Gernreich/four-hole-ocarinas/step/four-hole-ocarinas-rhombic-dodecahedron.step

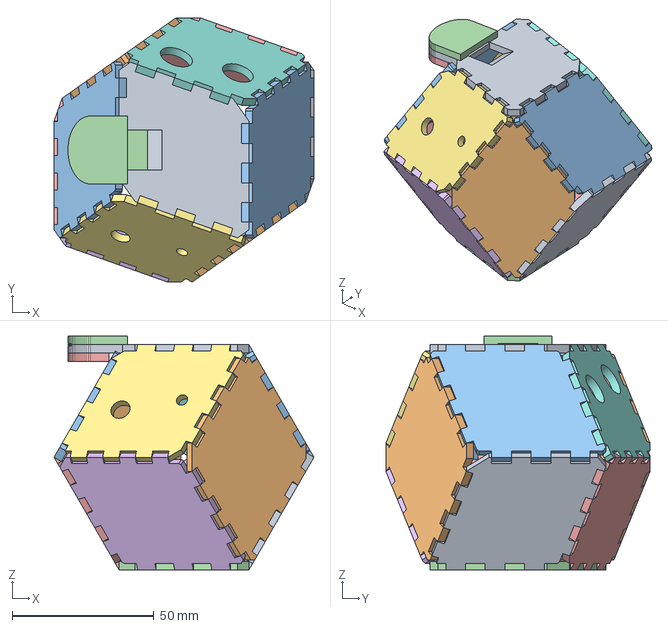
[picture p1: CAD file, 2026-11-12]
step/four-hole-ocarinas-rhombic-dodecahedron.step
91.6 x 93.2 x 82.4 mm
