Gernreich/four-hole-ocarinas/step/four-hole-ocarinas-square-antiprism.step

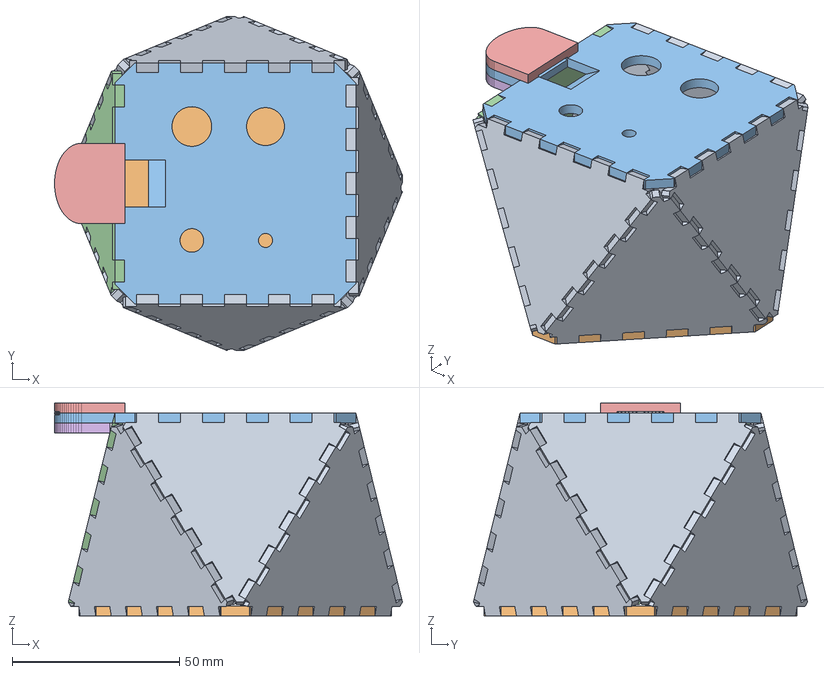
[picture p2: CAD file, 2026-11-08]
step/four-hole-ocarinas-square-antiprism.step
103.9 x 99.8 x 63.5 mm
