Gernreich/four-hole-ocarinas/step/four-hole-ocarinas-icosahedron.step

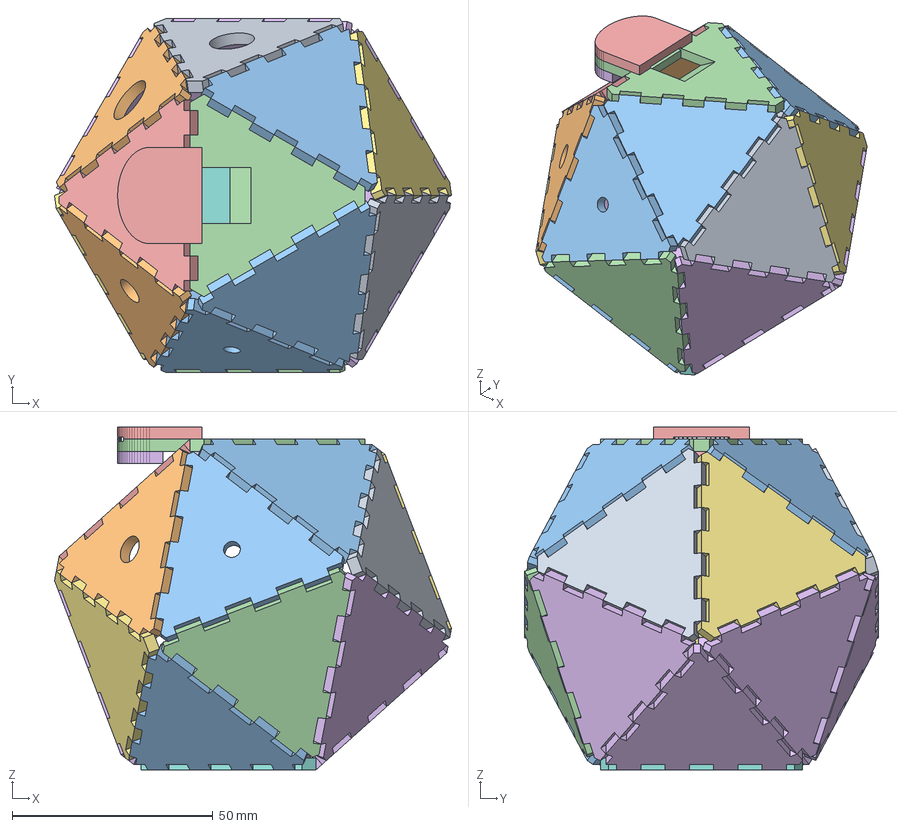
[picture p3: CAD file, 2026-11-08]
step/four-hole-ocarinas-icosahedron.step
98.9 x 88.2 x 85.4 mm
