Gernreich/four-hole-ocarinas/step/four-hole-ocarinas-octahedron.step

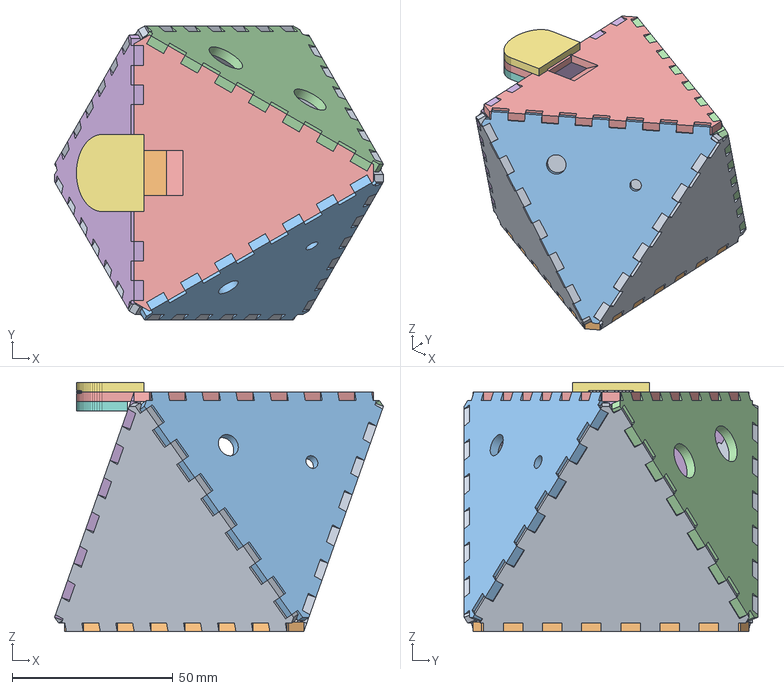
[picture p4: CAD file, 2026-11-08]
step/four-hole-ocarinas-octahedron.step
102.5 x 91.5 x 77.7 mm
