Gernreich/four-hole-ocarinas/step/four-hole-ocarinas-octagon.step

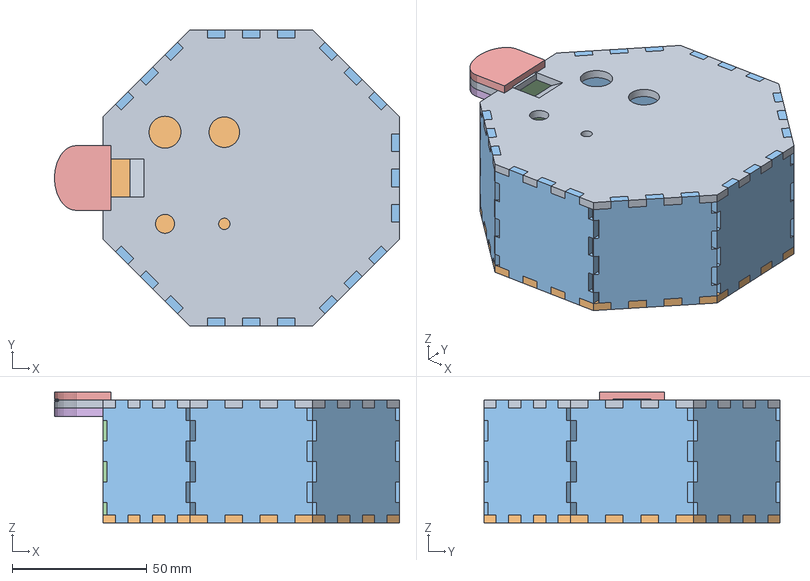
[picture p5: CAD file, 2026-11-08]
step/four-hole-ocarinas-octagon.step
128.0 x 110.0 x 48.6 mm
