Gernreich/four-hole-ocarinas/step/four-hole-ocarinas-cuboctahedron.step

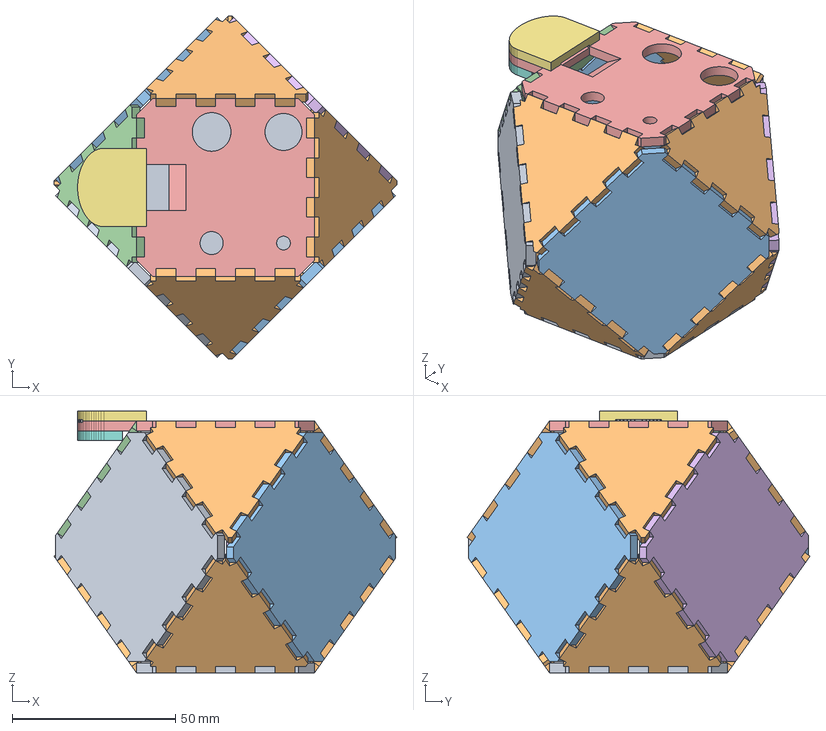
[picture p6: CAD file, 2026-11-08]
step/four-hole-ocarinas-cuboctahedron.step
105.0 x 105.0 x 80.1 mm
