Gernreich/four-hole-ocarinas/step/four-hole-ocarinas-hexagonal-prism.step

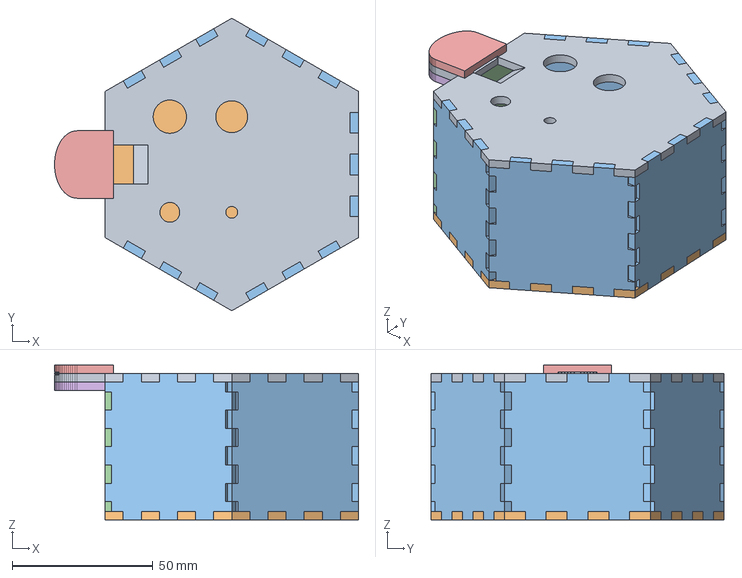
[picture p7: CAD file, 2026-11-08]
step/four-hole-ocarinas-hexagonal-prism.step
108.1 x 104.0 x 55.0 mm
