Gernreich/four-hole-ocarinas/step/four-hole-ocarinas-elongated-square-pyramid.step

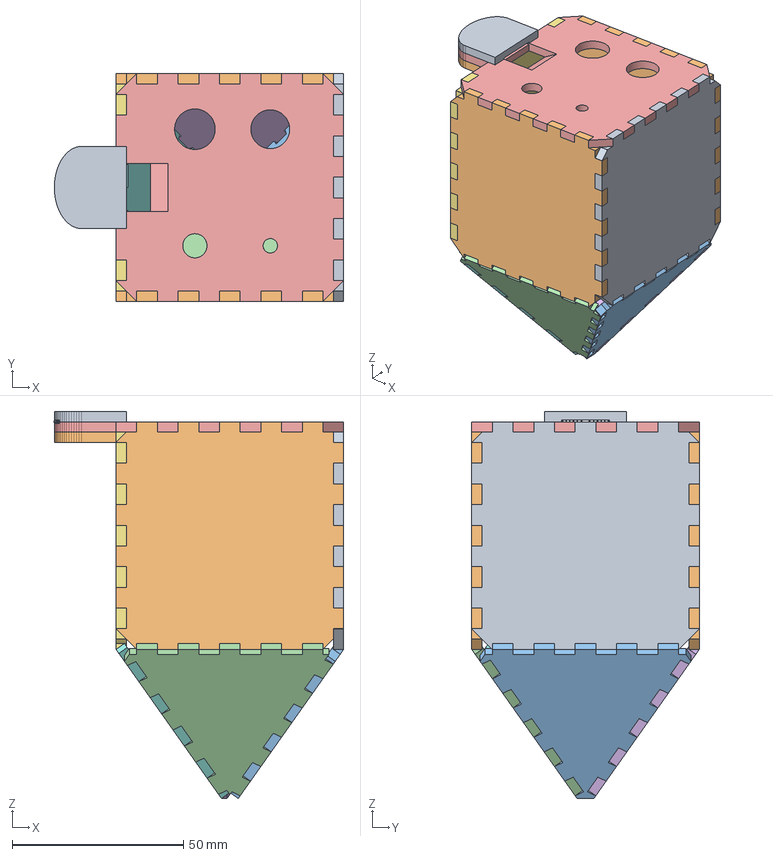
[picture p8: CAD file, 2026-11-08]
step/four-hole-ocarinas-elongated-square-pyramid.step
84.4 x 66.4 x 112.9 mm
