Gernreich/four-hole-ocarinas/step/four-hole-ocarinas-elongated-square-bipyramid.step

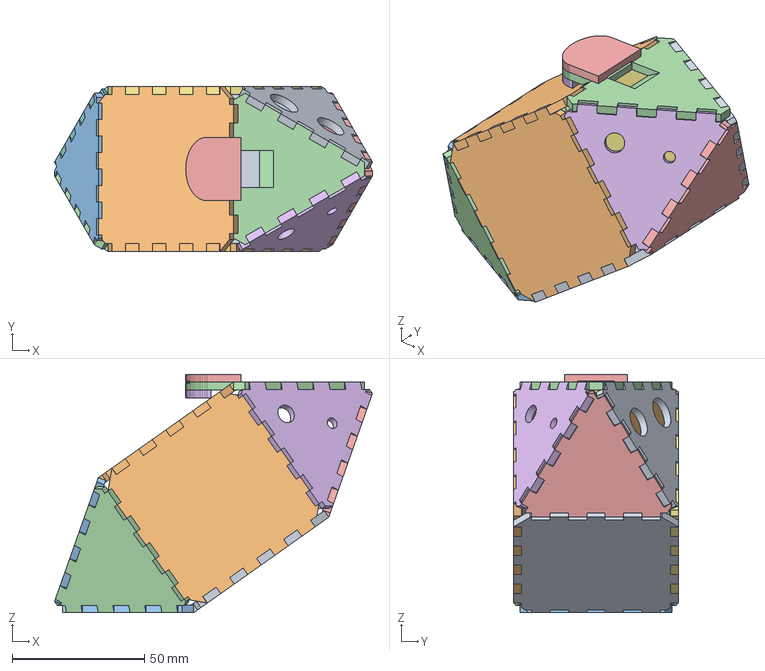
[picture p9: CAD file, 2026-11-08]
step/four-hole-ocarinas-elongated-square-bipyramid.step
120.4 x 62.6 x 90.3 mm
