Gernreich/four-hole-ocarinas/step/four-hole-ocarinas-dodecahedron.step

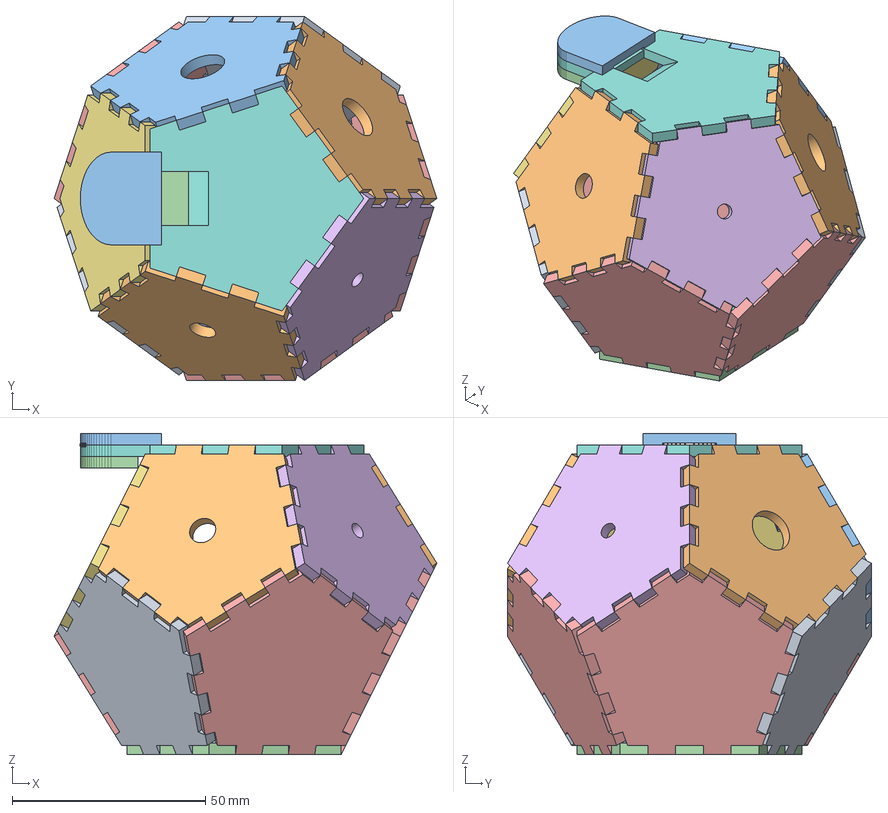
[picture p10: CAD file, 2026-11-08]
step/four-hole-ocarinas-dodecahedron.step
99.1 x 94.2 x 83.2 mm
