Gernreich/four-hole-ocarinas/step/four-hole-ocarinas-truncated-octahedron.step

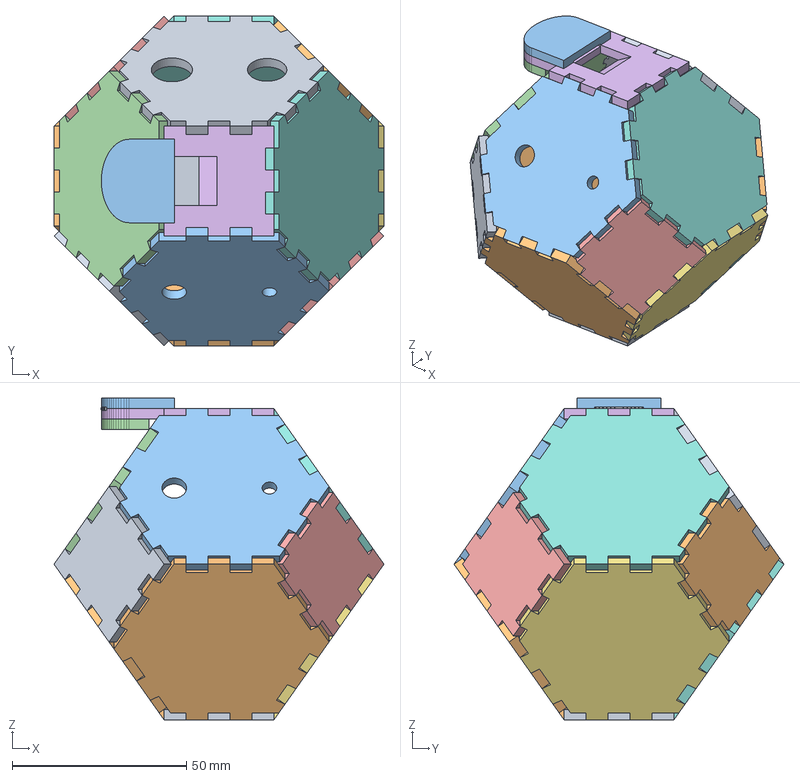
[picture p11: CAD file, 2026-11-08]
step/four-hole-ocarinas-truncated-octahedron.step
94.8 x 94.8 x 92.4 mm
