Gernreich/four-hole-ocarinas/step/four-hole-ocarinas-cube.step

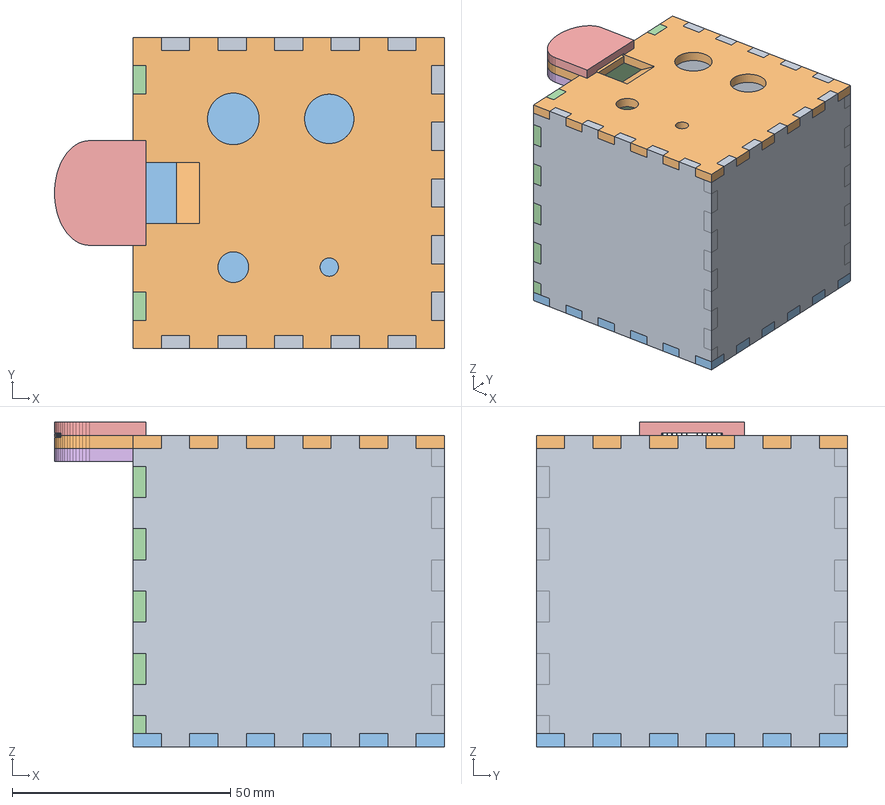
[picture p12: CAD file, 2026-11-08]
step/four-hole-ocarinas-cube.step
89.4 x 71.4 x 74.4 mm
