Gernreich/four-hole-ocarinas/(commit log)

2026-10-17 A four-hole ocarina in G4, English fingering, as a box and as a stack
    ocarina_model.py sizes the cavity and the four holes as a Helmholtz
    resonator; --search ranks the fingering patterns, and the one used heads
    the list at 12.3 cents. box_ocarina.py builds a finger-jointed box with a
    sliding tuning plug and a laminated stack, both on one sheet, with the
    square flute's joint and packer. page_assets.py draws the 3D view, the
    top plate to scale and the fingering chart.
2026-10-17 The box finger-jointed on all twelve edges
    At the author's asking, as many finger joints as possible: the end plugs
    become jointed end walls, and every edge runs fingers from corner to corner,
    the most odd cells of at least the square flute's 6mm (15 along, 9 across,
    3 up). Corner cubes go to the side walls; the mouth-end wall sends no
    fingers into the top under the beak. A new check samples 337 points over
    every cell and corner and finds each in exactly one plate. The sliding
    tuning plug goes with the plugs.
2026-10-17 The mouthpiece: one bird layer over the beak and a chin layer under it
    At the author's asking. Only the duct layer was ever needed for the sound;
    the other two bird layers were copied from the square flute. Now the beak
    is a three-ply sandwich, 9mm thick, with the duct near its middle. A check
    that the chin layer fills the beak and stops at the body.
2026-10-17 The beak's tip a half-ellipse, so it is not sharp on the lips
    At the author's asking: across the beak's 24mm and 8mm deep, on the top
    plate, the bird and the chin layer alike, with the duct's mouth following
    it. The kerf is now taken by a mitred offset, since the square flute's adds
    normals and is right only at right angles; on every rectilinear outline it
    gives the same points, and on the curve the cut runs 0.065mm out all round.
2026-10-17 Octagonal prism and truncated cube: solids jointed at every angle
    polyhedron.py joints any convex solid on every edge, stepping a plate back
    3mm x sin(angle) in its neighbour's fingers. The window, holes and fingering
    are the first set's, so each solid plays the same scale from its own key.
2026-10-17 Snub square antiprism (J85): five plates to a corner
    Corners nipped 3.5mm where plates that share only a corner would meet; a
    3D corner scan and a mouthpiece scan now check every solid. Holes go on
    their own triangles; the mouth triangle steps back under the beak.
2026-10-17 Snub cube: the fifth set
    38 faces, every corner five plates with a square among them; built as J85
    is, with corners nipped 2.5mm (2.0mm the least that clears).
2026-10-18 Solids: cube, square antiprism, octahedron, dodecahedron for the snubs
    The snub square antiprism and the snub cube go. polyhedron.stand() builds
    any solid from its corners, flat on its top face with an edge square to -x.
    The octahedron gives each hand a triangle with two holes, placed by pair();
    the dodecahedron a pentagon per hole. The antiprism's and octahedron's
    four-plate corners are nipped 4.25 and 4.75mm (3.75 and 4.25 the least
    that clear). README compares the joint with Boxes' Platonic generator.
2026-10-18 Name the page Four-hole ocarinas: it is no longer only a box
2026-10-18 Rename the repository four-hole-ocarinas
    box_ocarina.py is four_hole_ocarinas.py and every file named box-ocarina-*
    is four-hole-ocarina-*; the cut files are unchanged.
2026-10-18 Solids: the bird's duct face down, as the box's
    Its frame put the engraved face, w = 0, on top, so the 3D view drew the
    duct over the bird. Turned over about U; the cut files are unchanged.
2026-10-18 Solids: every plate numbers its corners
    Every corner of a solid has a number, and each plate line-engraves it near
    each of its corners, in red, on its inside face, so the plates that meet
    at a corner all show it. The plates are drawn inside face up for that;
    the 3D view draws the numbers too. Checked: every corner of every plate
    numbered, clear of the joints, holes and window.
2026-10-18 3D view: label every plate's corner numbers
    White on red, facing the camera, on the plates turned toward it, all of
    them seeing through the walls; a Corner numbers box turns them off.
2026-10-18 Corner numbers in the house blue, not red
    Blue engraves, labels included, in every repository here; the numbers
    are single lines beside the duct's fill.
2026-10-18 --kerf=; the solids in the tuning steps, a file list
    Review: tuning covered only the box and stack; --heard redraws every
    build and reads the box's cavity; finger sizes for the solids; sharps
    written one way; a Files table and the licence line, as the flute has.
2026-10-18 Savanna duct in two inks: red in the bird, magenta in the top
    Every sheet carries both halves of the duct, each its own colour, so the
    laser runs a bird flue, a nest flue or both. The solids' top plates are
    drawn outside face up and lose their corner numbers. The box's and the
    stack's top plates were placed inside face up in 3D, which showed the
    hands' holes swapped; now checked for every build.
2026-10-18 3D: each half of the duct in its own ink
2026-10-18 A 14 x 7mm window for all seven, on a fingering that lets it grow
    The tightest fingering (12.3 cents) needs one hole 1.72 times the
    window's conductance, so a window big enough for the larger solids
    would need a 17mm hole. The pattern used now opens all four holes for
    G5, its biggest hole 1.07 times the window's, and the window grows to
    the 12mm hole that leaves filing room under 13mm: 14 x 7mm, every hole
    4.2 to 11.8mm. The box's and the stack's cavity grows to 155cm3 to keep
    G4; the solids move to D4 (A4 for the octahedron). Worst note 19.2
    cents. The box and the stack now check their cavity against a quarter
    wavelength too.
2026-10-18 Every build a solid: the G4 box becomes a cube, the octagon uniform
    At the 14 x 7mm window the G4 box ran 144mm, 157mm corner to corner
    inside against a 221mm quarter wave. A cube holds the same 155cm3 at
    93mm corner to corner: its edge is solved from the model's volume, so
    it still plays G4 and still measures the window for --heard. The
    laminated stack and the 72mm D4 cube go; the octagonal prism is made
    uniform, 45.6mm tall so its walls are square. Five builds: cube,
    octagon, square antiprism, octahedron, dodecahedron. The hole grid
    moves in to fit the cube's 53.7mm inside, and the checks now keep ply
    between the holes and the window.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
2026-10-18 The cube and the octahedron at about 280cm3
    The author asked for both near 280cm3: the cube's edge is now whatever
    holds 280cm3 (71.4mm), the octahedron's 91.5mm (281cm3, was 72mm and
    127cm3). Four builds now play near D4 and the octagon C4; no build is
    sized to G4, which stays the frame the model works the scale in. So
    --heard takes --cavity=, the volume of the build that was played, and
    any build's closed note measures the window. The plans lose G4 from
    their names.
2026-10-18 Four more solids: truncated octahedron, hexagonal prism, icosahedron, cuboctahedron
    Each at about 280cm3 (D4), as the cube and the octahedron, except the
    cuboctahedron: at 280cm3 its top left 1.3mm of ply beside the biggest
    hole, so it is 54.5mm and 303cm3 (C#4), 2.3mm. The truncated
    octahedron puts each hand's holes on a hexagon, the icosahedron each
    hole on a triangle. The icosahedron's five-plate corners and the
    cuboctahedron's four-plate ones are cut back 3.5mm, 0.5mm over the
    least the corner scan clears. Nine builds; 127 checks pass.
2026-10-18 A blue bevel guide on every top plate
    The splitting edge's 30 degree bevel is filed by hand. A single blue
    line, the window's width, now marks where that bevel meets the top's
    outside face: 3mm / tan 30 = 5.2mm past the window. The top lies
    outside face up already, for the nest's half of the duct, so the line
    lands on the face that is filed. Checked on every build: in place,
    over the cavity, clear of the holes.
2026-10-19 Tuning: fill all four solids' open corners; the cube's wavelength is 1187mm
2026-10-21 Review: name the fingering that kept the window at 10 x 5mm
2026-10-21 Review: count cells to an edge, the generator's word, not fingers
2026-10-22 Link back to all projects at the top of the README and the page
    The rest of the build files now points at lasermademusic.html, where the
    instruments moved when the root page became a directory.
2026-11-05 Three more solids: the rhombic dodecahedron and Johnson J8 and J15, from a survey
    solid_survey.py sizes 23 zonohedra and Johnson solids to 280cm^3 and runs
    each through the generator's own checks, holes on the top's grid and on
    the faces at each hand's side, and measures how the holes reach the hands.
    Of the eleven that pass, three are built: the rhombic dodecahedron and the
    elongated square bipyramid reach best of the solids whose top is too small
    for the grid (index to middle finger 23 and 20mm, against 27 to 42 on the
    four built), and the elongated square pyramid keeps the cube's grid.
    polyhedron.stand() turns the beak edge by its normal, not its midpoint,
    so a rhombus's edge runs square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
2026-11-07 Call lasermade-tools' Rust programs, not its Python scripts
    The tools became Rust on 2026-11-07: target/release/<name> in lasermade-tools
    (cargo build --release there) replaces python3 <name>.py, in commands,
    manifests and prose. Pages rebuilt; no generated file changes otherwise.
2026-11-07 four_hole_ocarinas.rs, polyhedron.rs: the mitred offset and the solids' joints in Rust, for the panpipes and chanters
2026-11-08 The generators are Rust: four_hole_ocarinas, polyhedron, ocarina_model, page_assets, solid_survey; every cut file, plan and page byte for byte the same
2026-11-08 Cargo.lock: bore-tmm now depends on lasermade-tools and roxmltree
2026-11-08 STEP files of the 3D view, for a CAD program
    One file per design in step/, one solid body per part, written from the
    3D page by lasermade-tools step-export and checked by .repro. Every file
    opens in SolidCraft with every body closed and no warnings.
    [four-hole-ocarinas-cube.step, four-hole-ocarinas-cuboctahedron.step, four-hole-ocarinas-dodecahedron.step, four-hole-ocarinas-elongated-square-bipyramid.step, four-hole-ocarinas-elongated-square-pyramid.step, four-hole-ocarinas-hexagonal-prism.step, four-hole-ocarinas-icosahedron.step, four-hole-ocarinas-octagon.step]
2026-11-08 The cube as a SolidCraft script; its STEP file written by SolidCraft
    four_hole_ocarinas --solidcraft=DIR writes the build as a SolidCraft
    command script from the same parts as its cut file: ply and the four
    finger holes as parameters, every sketch fixed. step/...-cube.step is now
    built from that script by solidcraft-cli, so its holes are true
    cylinders; the other eleven still come from step-export. The cavity
    check (outside box less the plates) measures 280.00 cm3 once the hole
    and window plugs are taken off. No cut file changes.
    [four-hole-ocarinas-cube.step]
2026-11-08 The cube's SolidCraft design is parametric: its size live, the joints following
    L, W, H, ply and finger are parameters, and the generator's joint rules are
    expressions: cells per edge as many as fit with none under finger, odd on
    the top's and bottom's edges, even on the upright ones, the top keeping its
    mouth edge under the beak. Checked against the generator's own parts body
    by body at 71.42 cube, 90 cube, 100x80x66 and 120x75x50: every body within
    0.001 mm. The hole sizes stay the model's; the cut files are unchanged.
    [four-hole-ocarinas-cube.step]
2026-11-08 The cube tunes itself: key_hz sets the size, the model sets the holes
    ocarina_model.rs's Helmholtz model as SolidCraft expressions: the window's
    conductance from window_w, window_l, ply and mouth; each hole's diameter
    from its ratio (the fingering search's result, now a parameter); the
    cavity, and so L, W and H, from key_hz. pitch_hz and semitones_a4 read
    back what the box sounds. The beak, its tip and the duct are expression
    outlines with beak, beak_w and tip live; the duct is engraved duct_depth
    into the top and the bird, and the window's far edge is filed to bevel.
    room_far and room_side say when the holes run into a wall, and the mouth
    edge builds at keep = 0. Checked against the generat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
    [four-hole-ocarinas-cube.step]
2026-11-08 Every build as a parametric SolidCraft design; every STEP file written by SolidCraft
    The eleven other solids get the cube's treatment: one size (edge, or flats for
    the octagon) that key_hz sets through a fitted cavity cubic, joints re-counted
    along every edge, corner nips, the beak, duct and bevel, and the holes. Holes on
    side faces are placed by the generator's two searches solved exactly as linear
    programmes, so they follow size, ply and the hole diameters; room reads the
    least web. The step-export rows give way to solidcraft-cli builds.
    [four-hole-ocarinas-cuboctahedron.step, four-hole-ocarinas-dodecahedron.step, four-hole-ocarinas-elongated-square-bipyramid.step, four-hole-ocarinas-elongated-square-pyramid.step, four-hole-ocarinas-hexagonal-prism.step, four-hole-ocarinas-icosahedron.step, four-hole-ocarinas-octagon.step, four-hole-ocarinas-octahedron.step]
2026-11-09 Ocarinas: --scale and --cavity-mm3 draw a build at another size
    The designs' s and the cube's cavity_mm3 now name the generator flag in their
    comments, so lasermade-tools' sc-replay can redraw a design resized in
    SolidCraft. Without the flags every cut file is byte-identical.
2026-11-12 rhombic dodecahedron design: the nip at the beak stops at its side line
    Where the beak runs out of the mouth edge across a nipped corner, the generator's clip leaves the beak alone and its side runs on to the nip line; the design cut a 1.2 mm² sliver the cut file keeps. Round trip 1.69 -> 0.023 mm.
2026-11-12 rhombic dodecahedron STEP rebuilt from the corrected design
    [four-hole-ocarinas-rhombic-dodecahedron.step]
